BONGMIN-AI/robot-arm-control/ros2_ws/src/robot_arm_description/meshes/printed/link_1_2_joint_origin_centered_binary.stl

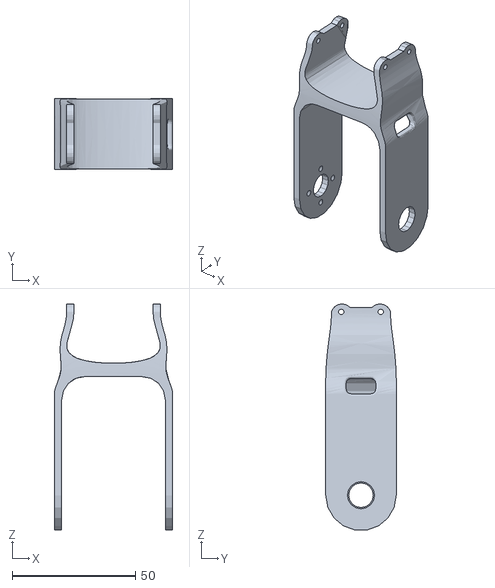
[picture p1: CAD file, 2026-08-28]
ros2_ws/src/robot_arm_description/meshes/printed/link_1_2_joint_origin_centered_binary.stl
48.0 x 28.6 x 91.6
