BONGMIN-AI/robot-arm-control/ros2_ws/src/robot_arm_description/meshes/printed/Base_disk_centered_binary.stl

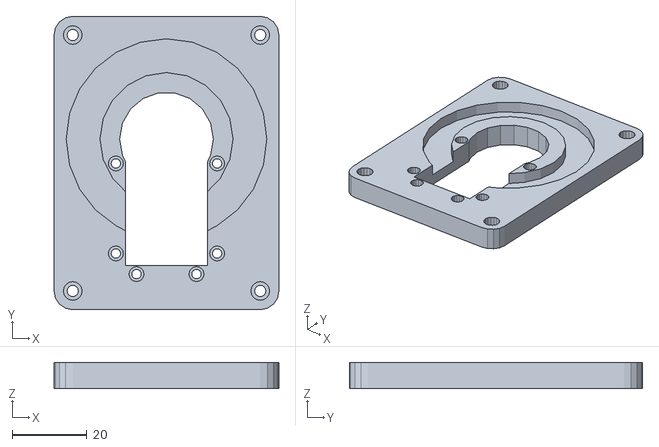
[picture p2: CAD file, 2026-08-28]
ros2_ws/src/robot_arm_description/meshes/printed/Base_disk_centered_binary.stl
60.0 x 78.2 x 7.00
