BONGMIN-AI/robot-arm-control/ros2_ws/src/robot_arm_description/meshes/printed/the_crawer_binary_left.stl

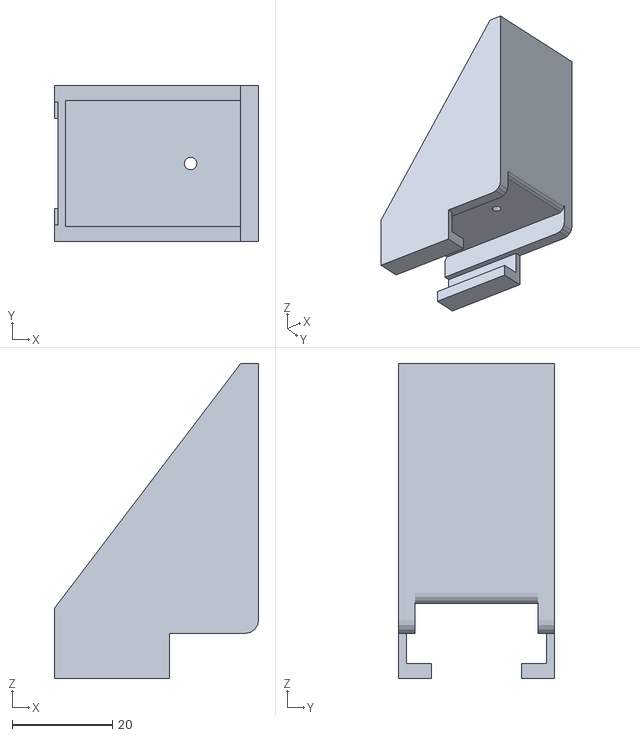
[picture p3: CAD file, 2026-08-28]
ros2_ws/src/robot_arm_description/meshes/printed/the_crawer_binary_left.stl
40.8 x 31.2 x 62.9
