BONGMIN-AI/robot-arm-control/ros2_ws/src/robot_arm_description/meshes/printed/link_0_centered_binary.stl

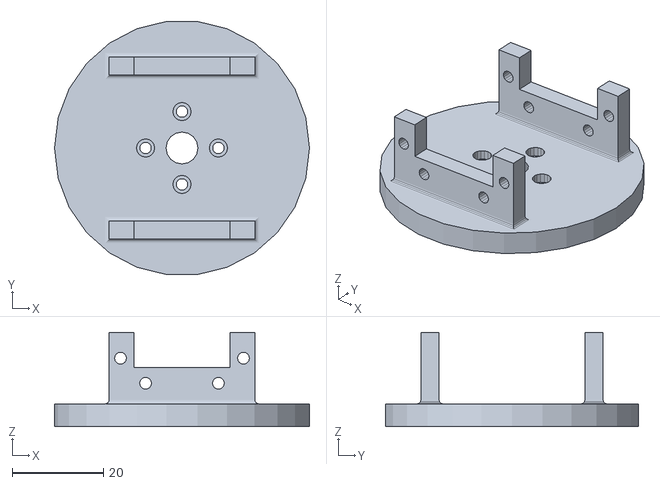
[picture p4: CAD file, 2026-08-28]
ros2_ws/src/robot_arm_description/meshes/printed/link_0_centered_binary.stl
56.0 x 55.6 x 20.7
