BONGMIN-AI/robot-arm-control/ros2_ws/src/robot_arm_description/meshes/printed/link_4_centered_binary.stl

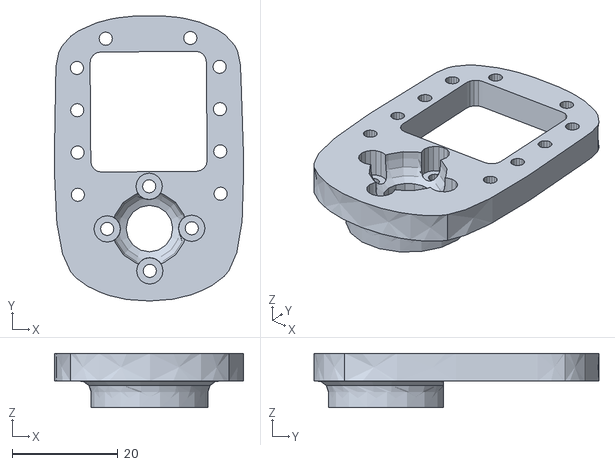
[picture p5: CAD file, 2026-08-28]
ros2_ws/src/robot_arm_description/meshes/printed/link_4_centered_binary.stl
35.8 x 53.9 x 10.3
