BONGMIN-AI/robot-arm-control/ros2_ws/src/robot_arm_description/meshes/printed/link_3_centered_binary.stl

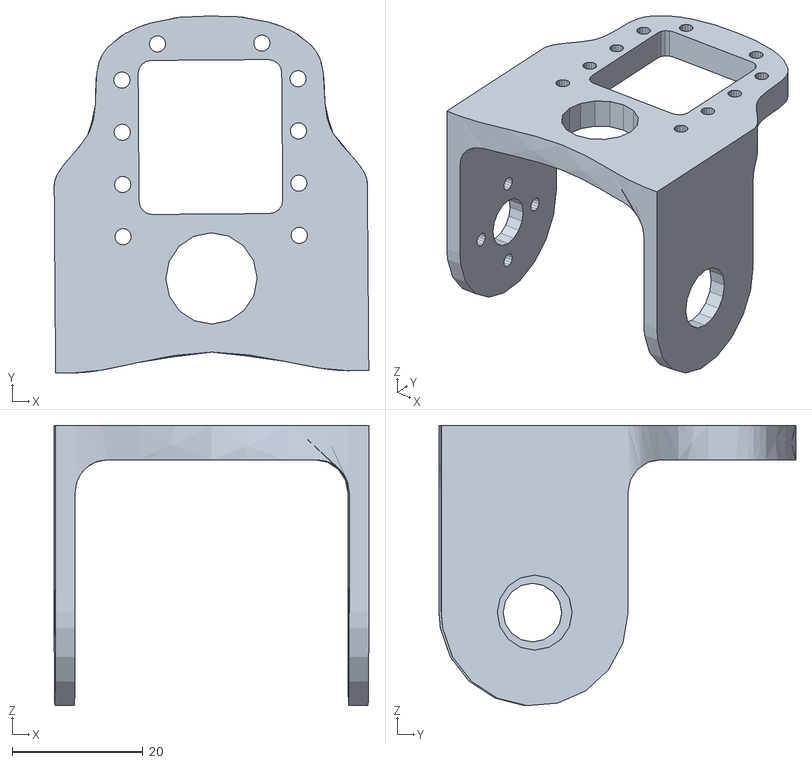
[picture p6: CAD file, 2026-08-28]
ros2_ws/src/robot_arm_description/meshes/printed/link_3_centered_binary.stl
48.2 x 54.7 x 43.0
