BONGMIN-AI/robot-arm-control/ros2_ws/src/robot_arm_description/meshes/printed/Base_0_centered_binary.stl

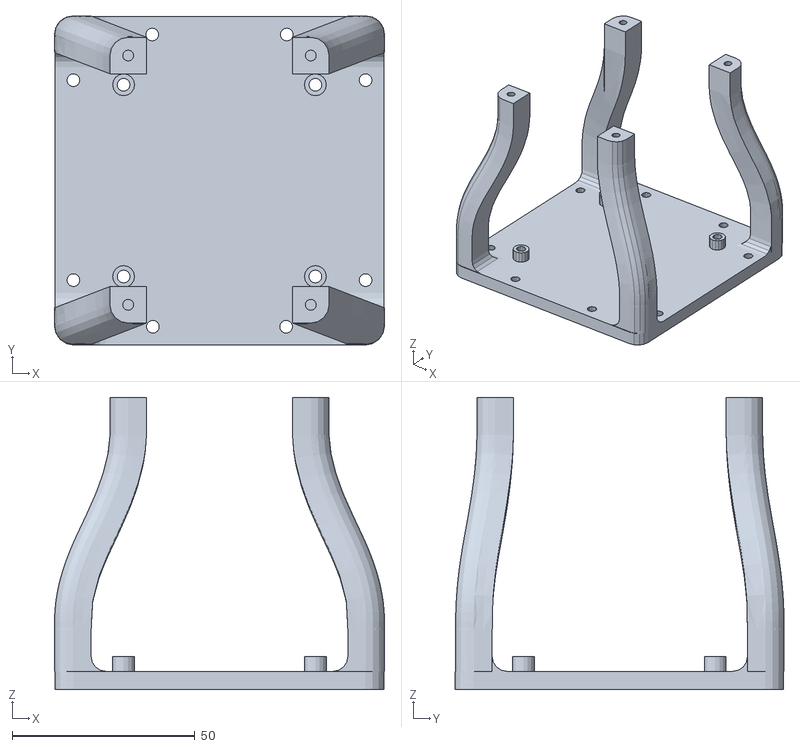
[picture p7: CAD file, 2026-08-28]
ros2_ws/src/robot_arm_description/meshes/printed/Base_0_centered_binary.stl
90.4 x 90.1 x 80.0
