BONGMIN-AI/robot-arm-control/ros2_ws/src/robot_arm_description/meshes/printed/the_crawer_base_centered_binary_180.stl

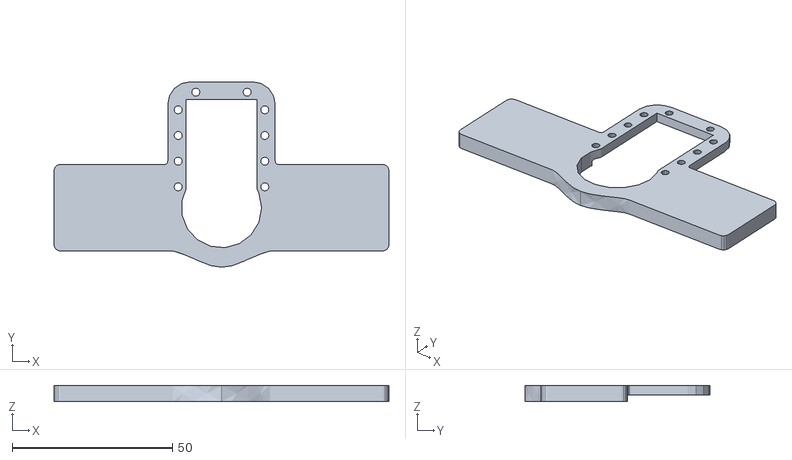
[picture p8: CAD file, 2026-08-28]
ros2_ws/src/robot_arm_description/meshes/printed/the_crawer_base_centered_binary_180.stl
104.4 x 57.8 x 5.00
