BONGMIN-AI/robot-arm-control/(list of files, cad)

Other CAD files:
ros2_ws/src/robot_arm_description/meshes/printed/the_crawer_binary_right.stl
