BONGMIN-AI/robot-arm-control/raspberry_pi/list_motions.py

import argparse

from motion_store import list_motions


def main():
    parser = argparse.ArgumentParser(description="List saved arm-play motion sequences.")
    parser.add_argument("--motion-dir", default=None)
    args = parser.parse_args()

    motions = list_motions(args.motion_dir)
    if not motions:
        print("No saved plays.")
        return

    for name in motions:
        print(name)


if __name__ == "__main__":
    main()
