BONGMIN-AI/robot-arm-control/raspberry_pi/list_recordings.py

import argparse

from recording_store import list_recordings


def main():
    parser = argparse.ArgumentParser(description="List saved hand-taught recordings.")
    parser.add_argument("--recording-dir", default=None)
    args = parser.parse_args()

    recordings = list_recordings(args.recording_dir)
    if not recordings:
        print("No saved recordings.")
        return

    for name in recordings:
        print(name)


if __name__ == "__main__":
    main()
