BONGMIN-AI/robot-arm-control/(commit log)

2026-07-31 Initial robot arm calibration project
2026-07-31 Add safe joint limits and motion planning
2026-07-31 Add AX-12A Raspberry Pi control skeleton
2026-07-31 Document Jetson testing and ROS2 troubleshooting
2026-07-31 Add ROS2 joint command listener skeleton
2026-07-31 Connect ROS2 joint commands to servo motion path
2026-07-31 Add ROS2 joint target sender command
2026-08-01 Persist mock servo state
2026-08-01 Document Jetson aliases
2026-08-01 Add safe torque control command
2026-08-02 Move gripper adjustment to forward motion end
2026-08-02 Finish return motions with gripper adjustment
2026-08-03 Harden gripper playback events
2026-08-03 Retry transient AX-12A packet errors
    [ax12a_driver.py]
2026-08-03 Set gripper recording range to 0-150
2026-08-03 Reduce recording playback sample sends
2026-08-03 Add arm play list command
2026-08-05 Update current robot arm roadmap
2026-08-28 Wait before disabling torque after homing
2026-08-28 Add inverse kinematics with calibrated joint limits
2026-08-28 Add captured arm poses and teaching recordings
2026-08-28 Add trimmed ROS 2 robot description model
    [Base_0_centered_binary.stl, Base_disk_centered_binary.stl, link_0_centered_binary.stl, link_1_2_joint_origin_centered_binary.stl, link_3_centered_binary.stl, link_4_centered_binary.stl, robot_arm.urdf.xacro, the_crawer_base_centered_binary_180.stl]
